TangRobot/CoLI/CAD/Follower/README.md

We recommend using the provided `.3mf` file to print the models in this fold. Follow the filament assignments and printing parameters specified in the file.

If you are printing with `.stl` files, please follow the requirements below.

- **`base` and `connection`:** Print using Bambu Lab PLA Tough+ with 4 wall loops.
- **`spool`:** Print using Bambu Lab PLA Basic with 4 wall loops and **Tree Supports (Auto)** enabled.
