TangRobot/CoLI/CAD/Calibrator/Sleeve_half_2.STL

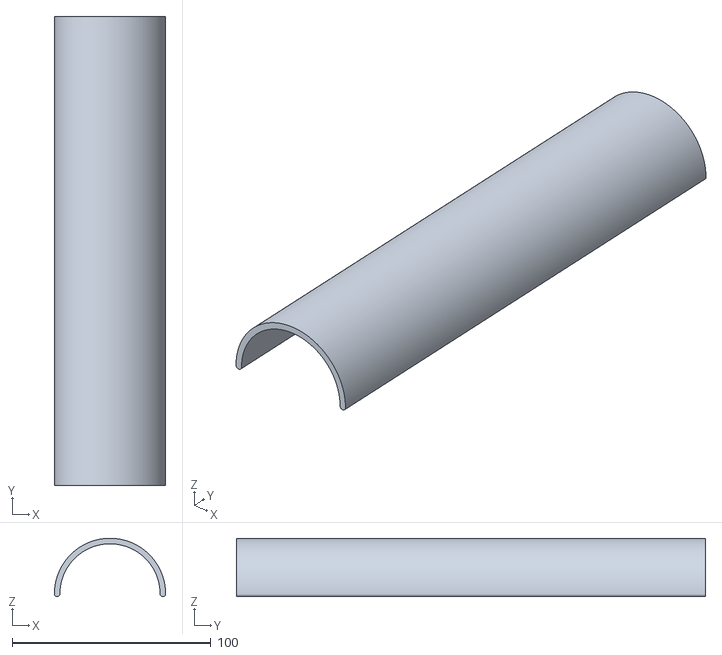
[picture p4: CAD file, 2026-10-19]
CAD/Calibrator/Sleeve_half_2.STL
56.0 x 236.0 x 29.4
