TangRobot/CoLI/CAD/Continuum_robot/Contunuum_robot_spacer-22.STL

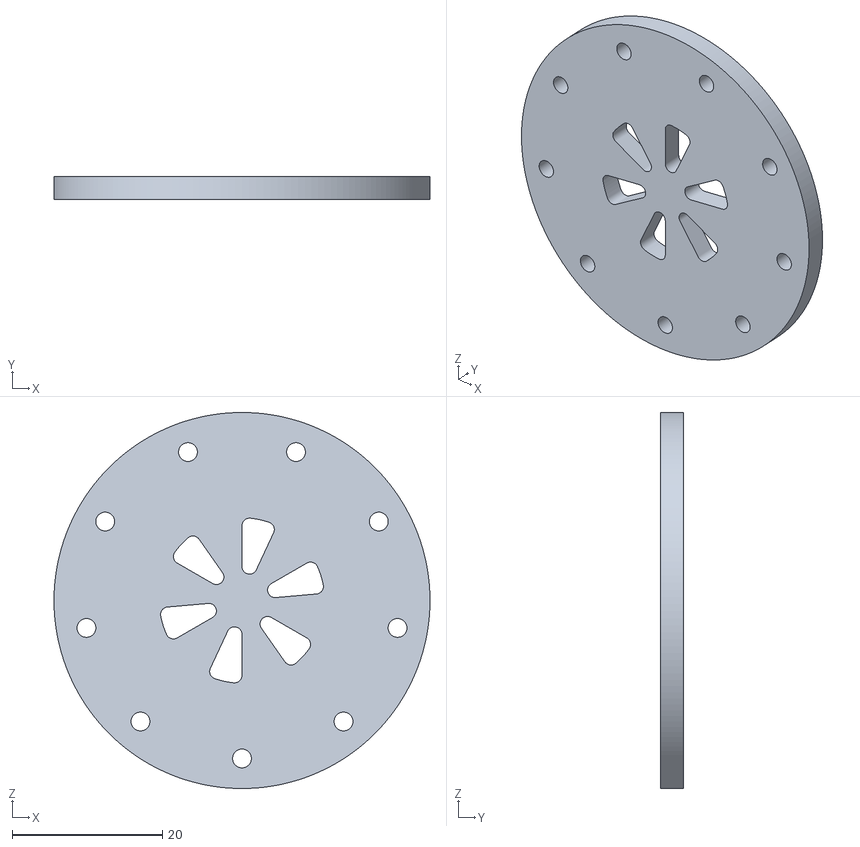
[picture p5: CAD file, 2026-10-18]
CAD/Continuum_robot/Contunuum_robot_spacer-22.STL
50.0 x 3.00 x 50.0
