TangRobot/CoLI/CAD/End_effector/Reflective_marker_base.STL

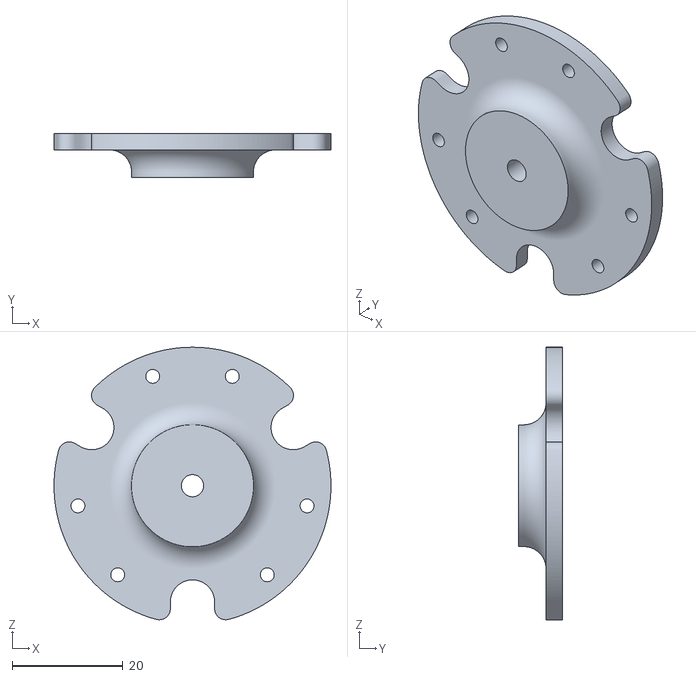
[picture p6: CAD file, 2026-10-20]
CAD/End_effector/Reflective_marker_base.STL
50.0 x 8.00 x 49.2
