TangRobot/CoLI/CAD/Follower/Follower_base.STL

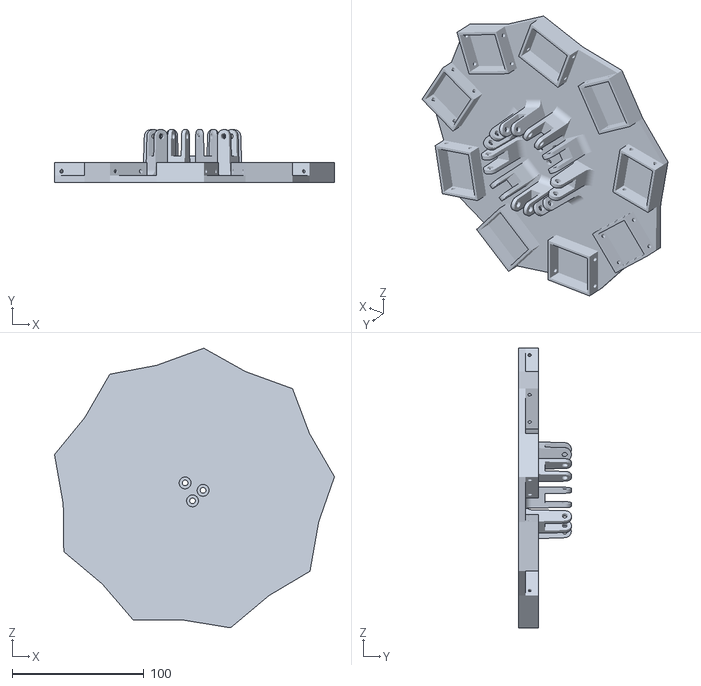
[picture p7: CAD file, 2026-10-18]
CAD/Follower/Follower_base.STL
212.8 x 40.0 x 212.5
