TangRobot/CoLI/CAD/Leader/Leader_base.STL

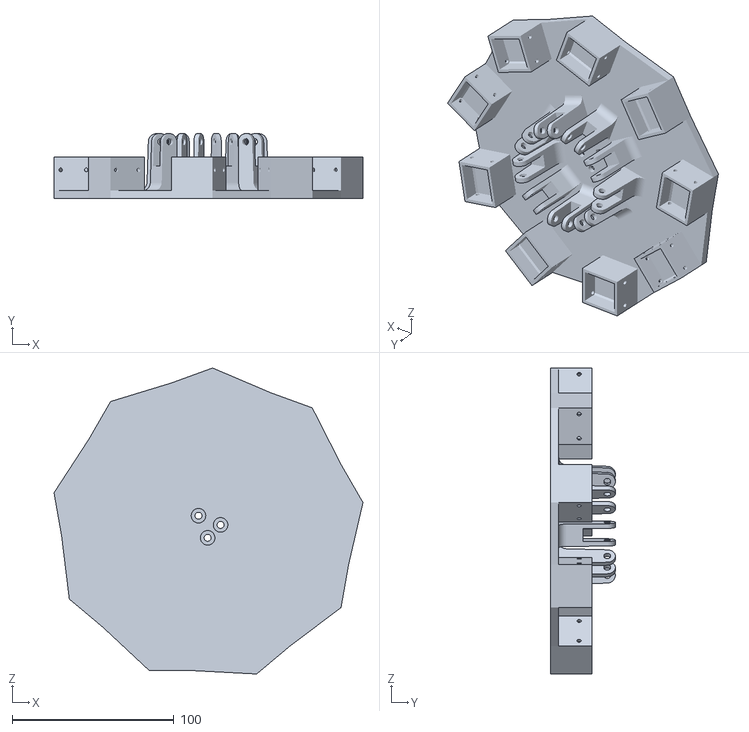
[picture p8: CAD file, 2026-10-18]
CAD/Leader/Leader_base.STL
191.0 x 40.0 x 189.2
