TangRobot/CoLI/CAD/Calibrator/Sleeve_half_1.STL

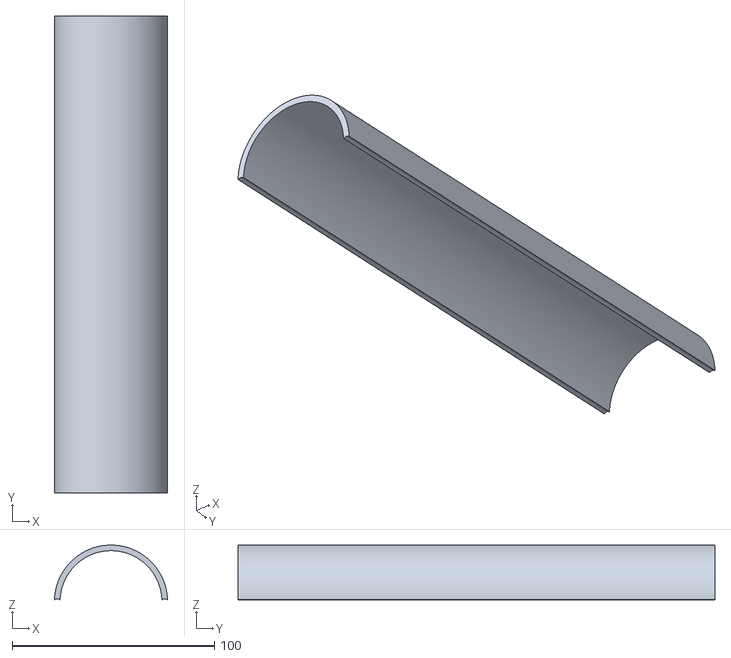
[picture p9: CAD file, 2026-10-19]
CAD/Calibrator/Sleeve_half_1.STL
56.0 x 236.0 x 27.2
