TangRobot/CoLI/CAD/End_effector/Hook.STL

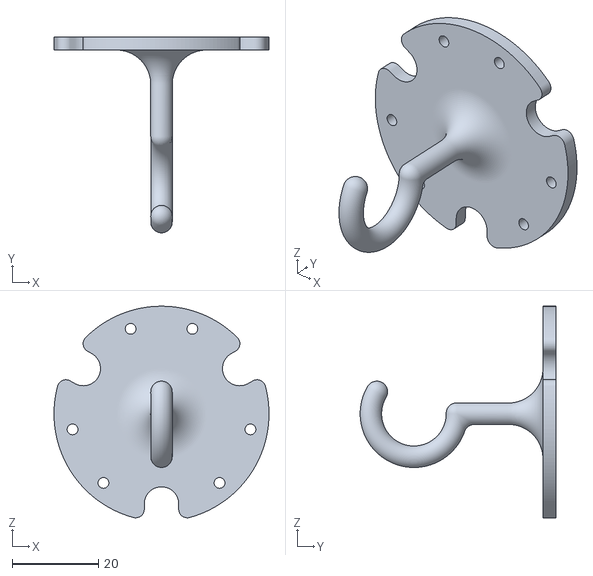
[picture p10: CAD file, 2026-10-18]
CAD/End_effector/Hook.STL
50.0 x 45.5 x 49.2
