TangRobot/CoLI/CAD/Follower/Follower.3mf

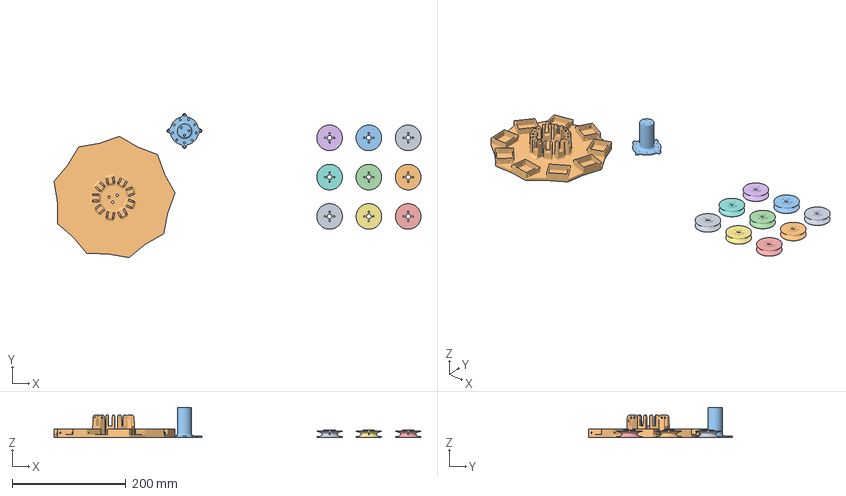
[picture p11: CAD file, 2026-10-18]
CAD/Follower/Follower.3mf
644.3 x 253.2 x 53.0 mm
Follower_spool.STL x 9
Follower_base.STL
Follower_connection.STL
