TangRobot/CoLI/CAD/Leader/Leader_connection.STL

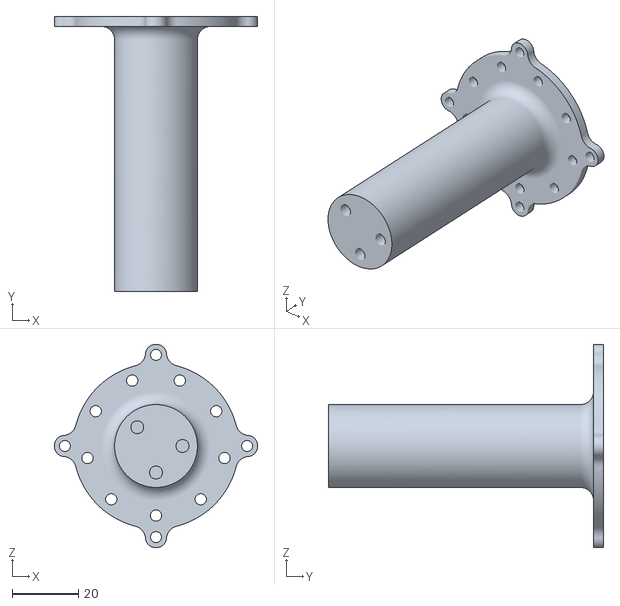
[picture p12: CAD file, 2026-10-18]
CAD/Leader/Leader_connection.STL
61.4 x 83.0 x 61.4
