TangRobot/CoLI/CAD/Calibrator/Sleeve.3mf

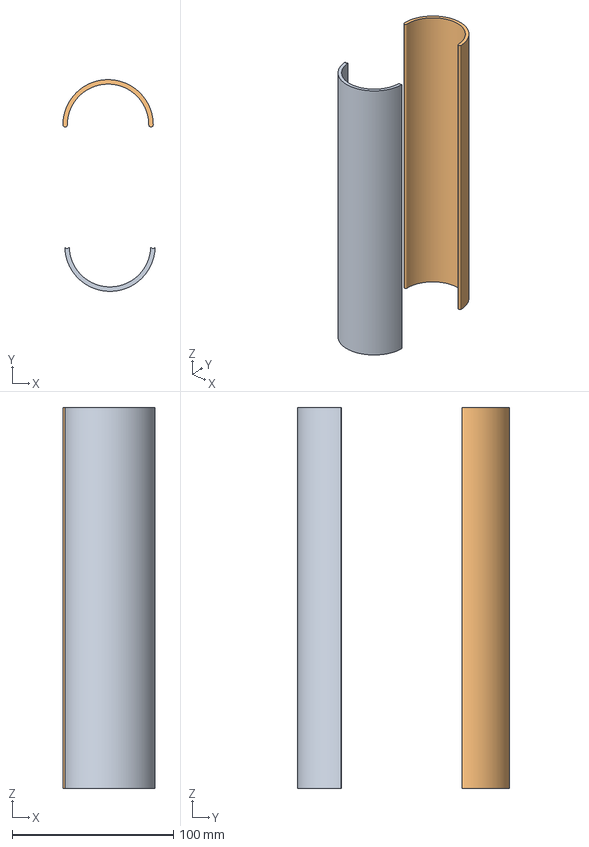
[picture p13: CAD file, 2026-10-19]
CAD/Calibrator/Sleeve.3mf
57.2 x 131.1 x 236.0 mm
Sleeve_half_1.STL
Sleeve_half_2.STL
