TangRobot/CoLI/CAD/End_effector/Rod.STL

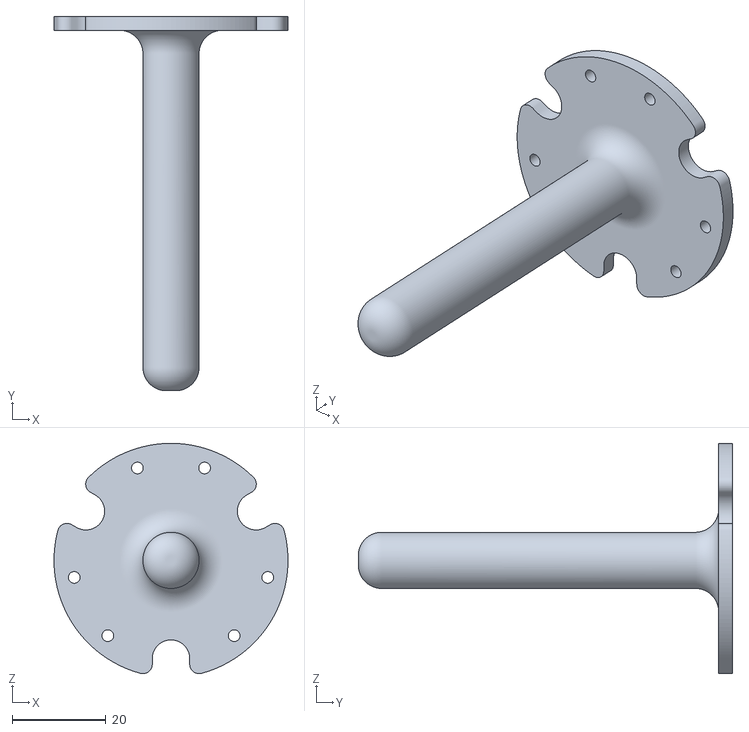
[picture p14: CAD file, 2026-10-18]
CAD/End_effector/Rod.STL
50.0 x 80.0 x 49.2
