TangRobot/CoLI/CAD/Follower/Follower_connection.STL

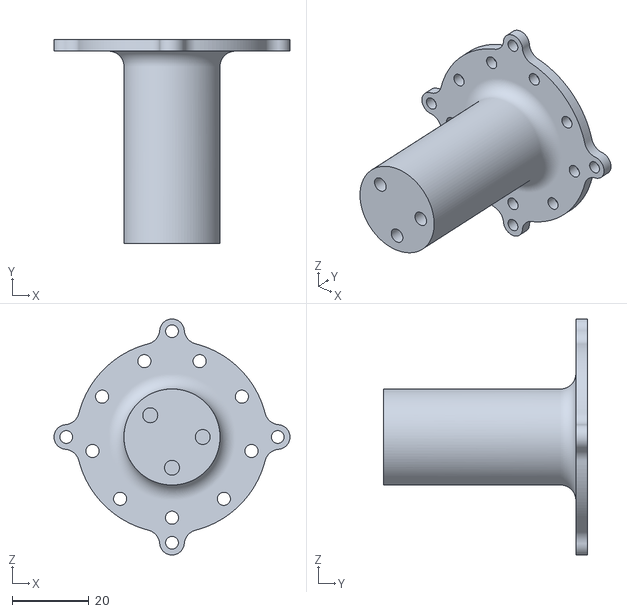
[picture p15: CAD file, 2026-10-18]
CAD/Follower/Follower_connection.STL
61.4 x 53.0 x 61.4
