TangRobot/CoLI/CAD/Leader/Leader_spool.STL

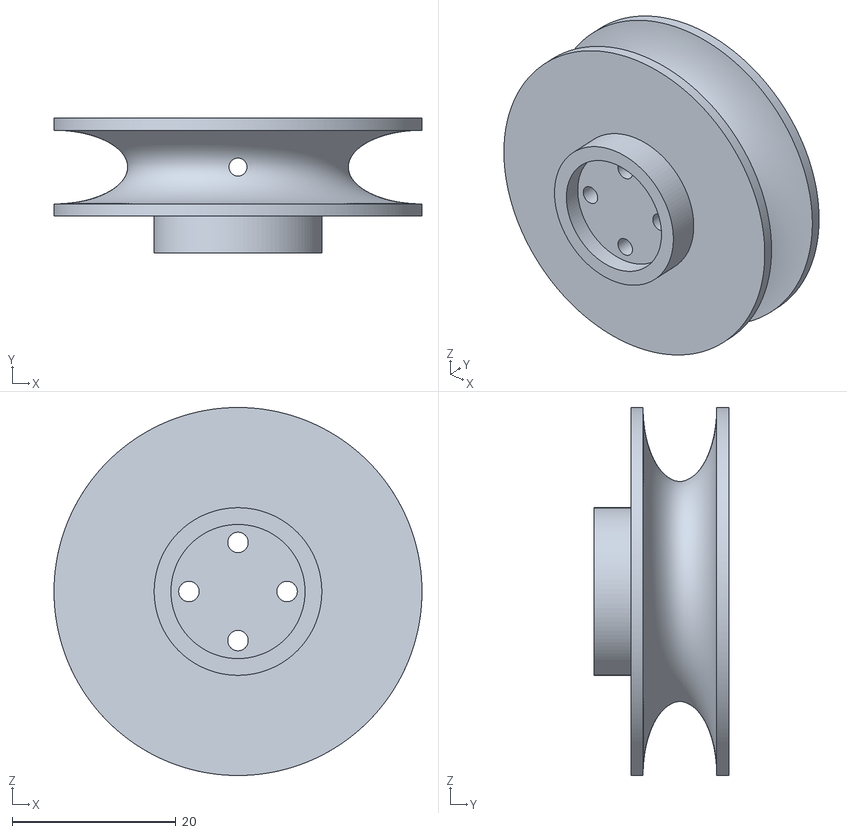
[picture p16: CAD file, 2026-10-18]
CAD/Leader/Leader_spool.STL
45.0 x 16.5 x 45.0
