TangRobot/CoLI/CAD/Follower/Follower_spool.STL

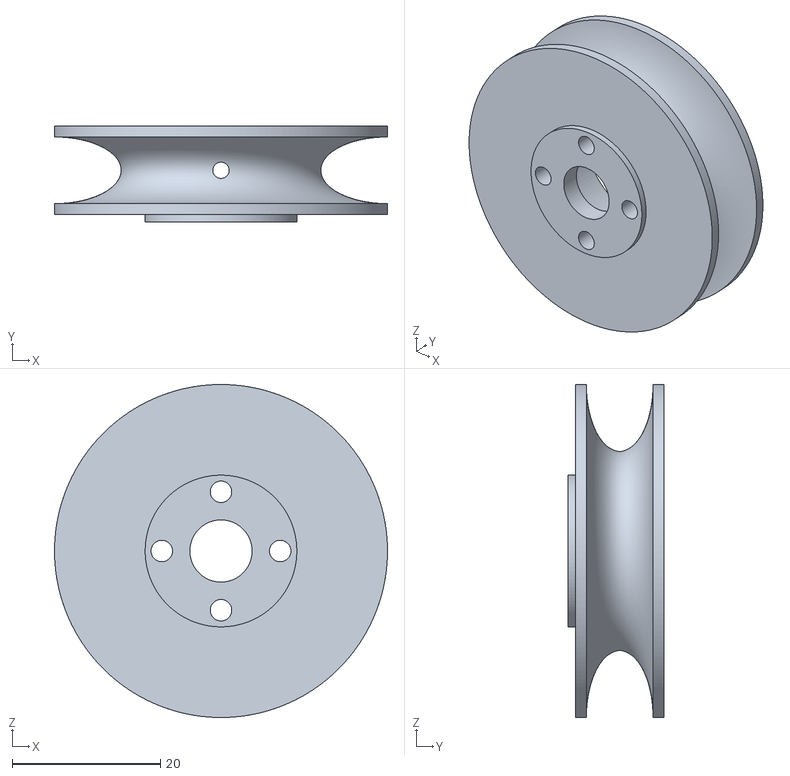
[picture p17: CAD file, 2026-10-18]
CAD/Follower/Follower_spool.STL
45.0 x 13.0 x 45.0
