TangRobot/CoLI/CAD/Leader/Leader.3mf

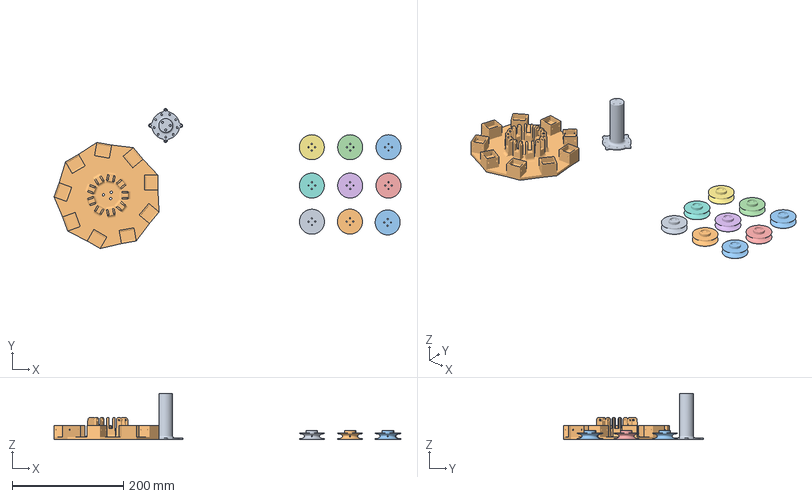
[picture p18: CAD file, 2026-10-18]
CAD/Leader/Leader.3mf
624.6 x 252.2 x 83.0 mm
Leader_connection.STL
Leader_base.STL
Leader_spool.STL x 9
