TangRobot/CoLI/CAD/Continuum_robot/Contunuum_robot_backbone.STL

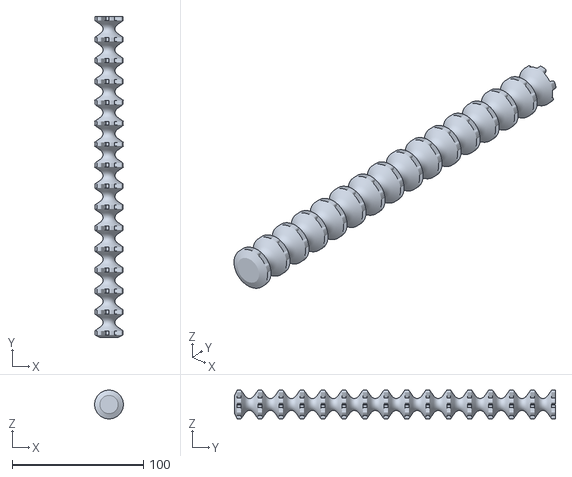
[picture p19: CAD file, 2026-10-18]
CAD/Continuum_robot/Contunuum_robot_backbone.STL
22.0 x 245.0 x 22.0
