TangRobot/CoLI/CAD/Continuum_robot/Contunuum_robot_spacer_bottom.STL

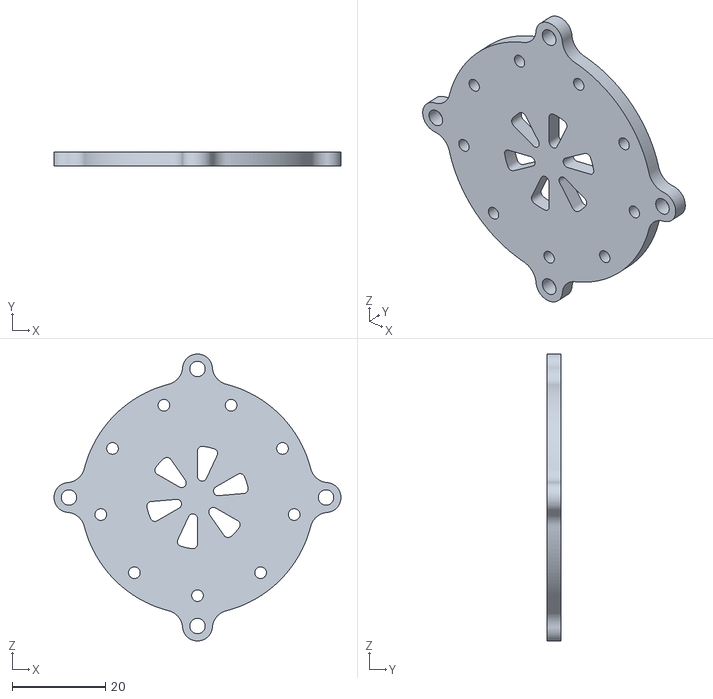
[picture p20: CAD file, 2026-10-18]
CAD/Continuum_robot/Contunuum_robot_spacer_bottom.STL
61.4 x 3.00 x 61.4
