TangRobot/CoLI/CAD/Continuum_robot/Continuum_robot.3mf

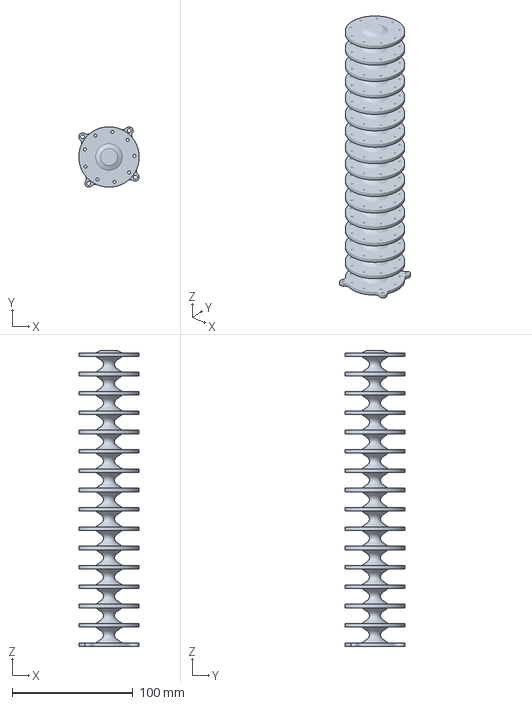
[picture p21: CAD file, 2026-10-18]
CAD/Continuum_robot/Continuum_robot.3mf
50.0 x 50.0 x 245.0 mm
