TangRobot/CoLI/(list of files, cad)

Other CAD files:
CAD/Continuum_robot/Contunuum_robot_spacer-20.STL
CAD/Continuum_robot/Contunuum_robot_spacer-29.STL
CAD/Continuum_robot/Contunuum_robot_spacer-19.STL
CAD/Continuum_robot/Contunuum_robot_spacer-25.STL
CAD/Continuum_robot/Contunuum_robot_spacer-28.STL
CAD/Continuum_robot/Contunuum_robot_spacer-23.STL
CAD/Continuum_robot/Contunuum_robot_spacer-26.STL
CAD/Continuum_robot/Contunuum_robot_spacer-30.STL
CAD/Continuum_robot/Contunuum_robot_spacer-18.STL
CAD/Continuum_robot/Contunuum_robot_spacer-3.STL
CAD/Continuum_robot/Contunuum_robot_spacer-21.STL
CAD/Continuum_robot/Contunuum_robot_spacer-31.STL
CAD/Continuum_robot/Contunuum_robot_spacer-27.STL
CAD/Continuum_robot/Contunuum_robot_spacer-24.STL
