TangRobot/CoLI/CAD/Calibrator/README.md

We recommend using the provided `.3mf` file to print the models in this fold. Follow the filament assignments and printing parameters specified in the file.

If you are printing with `.stl` files to print, please follow the requirements below.

- **`Sleeve_half_1` and `Sleeve_half_2`:** Print using PLA Basic with 5 wall loops.
