TangRobot/CoLI/(commit log)

2026-10-18 Add files via upload
    Add CAD files.
    [Continuum_robot.3mf, Contunuum_robot_backbone.STL, Contunuum_robot_spacer-18.STL, Contunuum_robot_spacer-19.STL, Contunuum_robot_spacer-20.STL, Contunuum_robot_spacer-21.STL, Contunuum_robot_spacer-22.STL, Contunuum_robot_spacer-23.STL]
2026-10-18 Fix formatting and clarify printing instructions
2026-10-18 Revise README for CoLI project documentation
    Updated README with detailed project description, materials, 3D printing instructions, assembly steps, and citation information.
2026-10-18 Fix formatting for 3D-Printed Parts in README
    Updated the table to correct formatting for 3D-Printed Parts.
2026-10-26 Add MakerWorld model page link to README
    Added a link to the MakerWorld model page for easy access to download and print the continuum robot models.
2026-10-26 Add prime tower instructions for STL printing method
    Added details about using a prime tower in the alternative printing method section.
